Matrixiem637/Practice-Enterprise-1/Verslag/Fotos/shelly-plus-1-gen3-1-300x300.jpeg

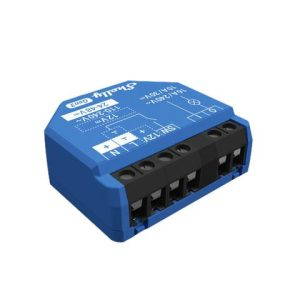
Verslag/Fotos/shelly-plus-1-gen3-1-300x300.jpeg
