Matrixiem637/Practice-Enterprise-1/Verslag/Fotos/WhatsApp Image 2026-05-21 at 21.13.31.jpeg

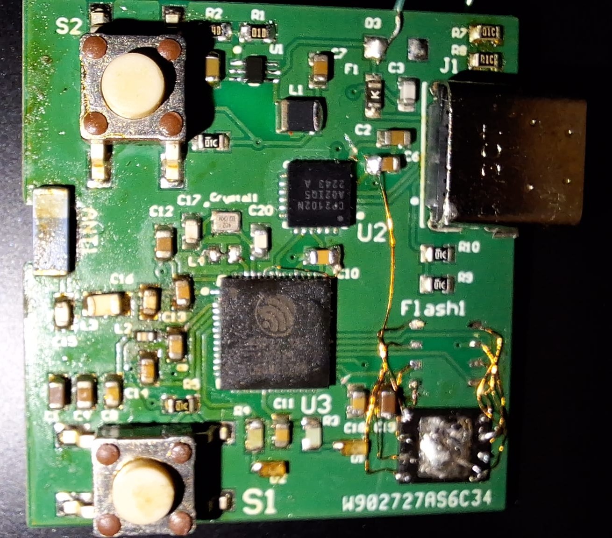
Verslag/Fotos/WhatsApp Image 2026-05-21 at 21.13.31.jpeg
