Matrixiem637/Practice-Enterprise-1/Verslag/PE1 project template 2025.docx

2025 - 2026

PE1 – Shelly Hub

By Dergent Toon and Mateusz Kidrycki

# 1. Preface

During the course Practice Enterprise 1, you will work on a project of your own choosing within a professional and enterprise-oriented context.

The aim of this course is to bridge the gap between theory and practice by allowing you to explore, develop, and realize a project that reflects your interests and ambitions.

Through this project we want to improve the following competences

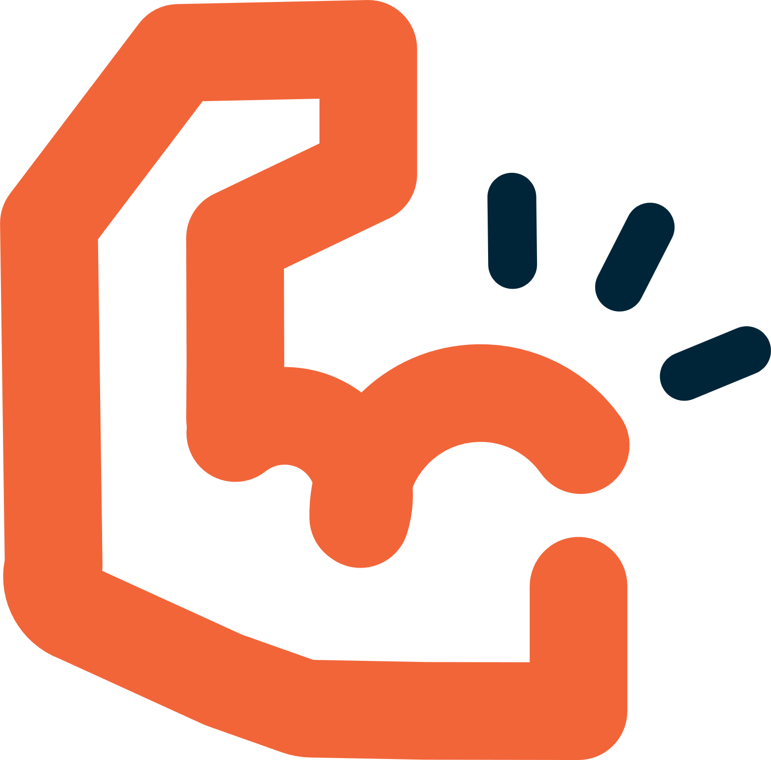
[picture p3: figure]

- Taking initiative and responsibility in defining and executing a project.
- Applying theoretical knowledge in a practical and structured manner.
- Developing professional communication and collaboration skills.
- Planning, organizing, and monitoring your own work.
- Reflecting critically on your process, decisions, and results.

Throughout the semester, you will independently (and where applicable, in team) work on your project. You are expected to define clear objectives, make well-founded choices, and document your progress in a structured and professional way.

This template serves as a guideline for documenting your project, process, and outcomes. It should provide a clear overview of your approach, the steps you have taken, and the results you have achieved.

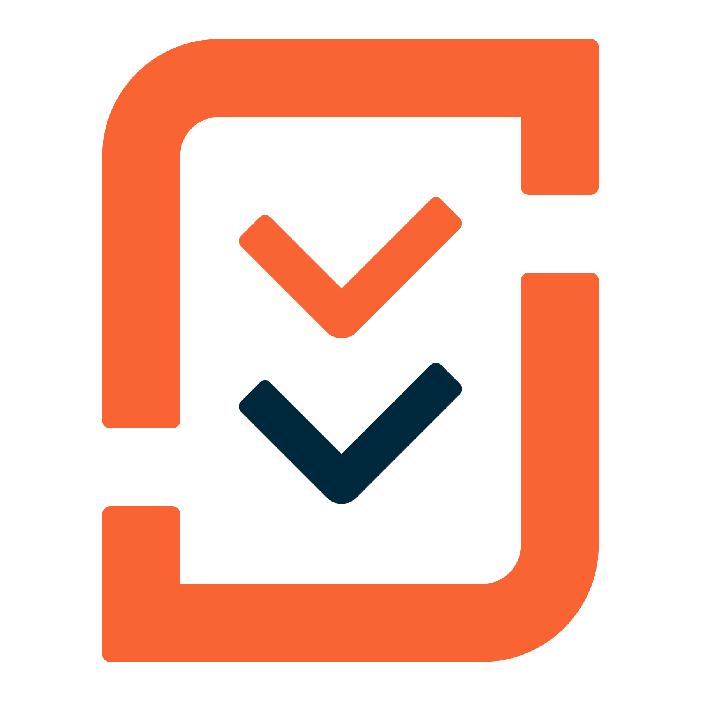
[picture p4: figure]

The following items need to be included:

- Project description and objectives
- Planning and approach
- Implementation and progress
- Communication and collaboration (if applicable)
- Reflection on decisions, challenges, and results
- Supporting material (e.g. screenshots, documents, reports, schematics, …)

Complete the different sections of this document throughout the semester. Feedback will be provided where necessary to support your learning process.

Please note this document should only be completed once per group!

Upload this document at the latest a day before your presentations on the assignment provided on canvas.

# 2. Group members

In the evaluation, different marks can be awarded to the members of the same project group as realization, contribution and knowledge are student dependent.

| Student 1 | Student 2
First name | Toon | Mateusz
Surname | Dergent | Kidrycki
R-number | R1093663 | R1094110

# 3. Project Definition

## 3.1. Project Description

### 3.1.1. Context and Motivation

Er is steeds meer vraag naar smart home apparaten, waarbij Shelly apparaten populair zijn vanwege hun open karakter en wifi connectiviteit. De motivatie voor dit project te creëren van een centrale hub om verschillende Shelly apparaten te beheren zonder afhankelijk te zijn van de standaard cloud app wat de privacy en snelheid ten goede komt.

### 3.1.2. Problem Statement

Het beheren van meerdere smart home apparaten via verschillende interfaces of een externe Cloud omgeving kan leiden tot vertraging, privacy zorgen en een gebrek aan overzicht. Er is behoefte aan een lokale gebruiksvriendelijke “hub” die alle Shelly apparaten binnen een netwerk visualiseert en aanstuurt.

## 3.2. Objectives

### 3.2.1. Main Objectives (Must-Haves)

- Automatische connectie of handmatige toevoeging van Shelly apparaten in het netwerk.
- Centraal dashboard voor bediening.
- Lokale communicatie.
- Automatisering op basis van tijd of sensoren.

### 3.2.2. Expansions (Nice-To-Haves)

- Real time statuslezing (Aan/Uit, stroomverbruik).
- Data logging (bv. Grafieken van stroomverbruik.
- Mobiele responsiviteit van de interface.

# 4. Preparation

## 4.1. What do you need for your project?

Voor de realisatie van ons project hebben we een eigen ontworpen PCB nodig die de centrale hub vormt van alle Shelly apparaten. Op deze printplaat plaatsen we een microcontroller met Wi-Fi zoals de ESP32 zodat de hub verbinding kan maken met het lokale netwerk (of hotspot). Dit is essentieel om de andere Shelly toestellen te kunnen opsporen en aan te sturen. Daarnaast hebben we componenten nodig voor de voeding en een aantal LEDs om te kunnen zien of de hub goed opstart en verbonden is.

Voor het ontwerpen van de elektronische schema’s en de lay-out van de printplaat gebruiken we Altium Designer. Het schrijven van de software voor de microcontroller doen we in Visual Studio Code. In deze code zorgen we ervoor dat de hub kan communiceren met de API van de Shelly apparaten.

## 4.2. Existing Solutions

Er bestaan natuurlijk al oplossingen zoals de officiële Shelly app en grote platformen zoals Home Assistant of Google Home. De app van Shelly werkt echter vaak via de Cloud en systemen zoals Home Assistant zijn vaak te complex.

Ons project is uniek omdat we niet alleen software maken maar ook de hardware zelf ontwerpen. We bouwen een fysiek hub op een eigen PCB die alles lokaal regelt zonder dat er internet voor nodig is. Hierdoor is onze oplossing een stuk sneller privacy vriendelijker en speciaal gemaakt voor wie een simpel en direct overzicht wil van zijn Shelly apparaten.

# 5. Planning

09/02-18/02 | Voorbereiden project + Voorstellen project
18/02-03/04 | Componenten Bestellen PCB ontwerpen + Bestellen
21/04 | PCB bestukken
21/04-22/05 | PCB bijwerken indien nodig + Code schrijven
11/05-24/05 | Verslag en PowerPoint opmaken
26/05 | Verdediging PE1

# 6. Realisation

## 6.1. What did you do?

### 6.1.1. Explanation of your work.

Nadat we het projectvoorstel hadden opgesteld en laten goedkeuren hebben we de ESP32S3 gekozen als centrale microcontroller vanwege de rekenkracht en de ingebouwde Wi-Fi ondersteuning. Na het vastleggen van de specificaties hebben we het elektrisch schema opgesteld en de juiste componenten geselecteerd met behulp van de datasheets. Vervolgens hebben we in Altium Designer de PCB lay-out ontworpen. Na feedback hebben we het design geoptimaliseerd en de PCB besteld.

Tijdens de levertijd van de PCB hebben we de software alvast grotendeels ontwikkeld op een ESP development bordje zodat we de communicatie met de Shelly API konden testen. Zodra de printplaten aangekomen waren hebben we deze zelf bestukt en gesoldeerd. Het laatste deel bestond uit het integreren van de software op onze eigen hardware en het valideren van de lokale hub functionaliteit.

### 6.1.2. Hardware

- ESP32S3: Dit is de kern van onze hub. We hebben voor de S3 variant gekozen vanwege de krachtige processor en de Wi-Fi mogelijkheden. Dit is essentieel om zowel de web interface te hosten als tegelijkertijd stabiel te communiceren met de Shelly apparaten in het netwerk.
- Flash Geheugen: Omdat de gekozen ESP32 geen ingebouwd geheugen heeft hebben we een externe flash chip bij op de PCB gezet. Hierop wordt de software die op de ESP moet runnen opgeslagen.
- USB naar UART-bridge: Om de microcontroller te kunnen programmeren en debuggen via de computer is er een bridge toegevoegd. Deze zorgt voor de vertaling van de USB-signalen naar de seriële data die de ESP32 kan verstaan en verwerken.
- Spanningsregeling: De hub krijgt zijn voeding via de USB-poort op 5V. omdat de ESP32 en de flash beide op 3.3V werken hebben we een regulator nodig om deze spanning stabiel en veilig om te vormen van 5V naar 3.3V.
- USB-C Connector: We hebben gekozen voor een USB-C aansluiting voor de voeding en data. Dit is niet alleen een moderne standaard maar het biedt ook een stevige mechanische verbinding op de printplaat.
- Cystal Oscillator: Voor de interne klok van de ESP32 hebben we een extern crystal toegevoegd. Dit component is nodig om de timing van de processor juist te laten lopen en zorgt ervoor dat de draadloze communicatie op de juiste frequentie verloopt.
- Antenne: Om een stabiel bereik te garanderen is er een antenne voorzien. Deze zorgt ervoor dat de hub ook op grotere afstanden probleemloos verbinding kan maken met het wifi netwerk en de Shelly devices.
- Status LED’s en Drukknop: Om zonder computer te kunnen zien wat de status van de hub is hebben we enkele LED’s toegevoegd. Zo kunnen we direct zien of de hub verbonden is met de wifi of apparaten. Ook is er een fysieke drukknop aanwezig om handmatige acties of reset te kunnen uitvoeren.

### 6.1.3. Software

#### 6.1.3.1. Ontwikkelomgeving: ESP-IDF

Voor de ontwikkeling van de firmware wordt gebruikgemaakt van het ESP-IDF framework(Espressif IoT Development Framework). Dit is het officiële framework van Espressif en heeft alle nodige drivers en libraries. FreeRTOS is hierin geïntegreerd als real-time besturingssysteem.

#### 6.1.3.2. Wifi-verbinding

De ESP32 verbindt zich met een bestaand wifi-netwerk als station. Om de web interface altijd bereikbaar te houden wordt een vast IP-adres ingesteld in plaats van een dynamisch adres via DHCP.

Wanneer er een gebeurtenis plaatsvindt, zoals het verkrijgen van een IP-adres of het verbreken van de verbinding, wordt automatisch een bijbehorende functie opgeroepen via de event loop van ESP-IDF. Bij verbindingsverlies probeert de ESP32 zelf opnieuw te verbinden. De systeemklok blijft ondertussen gewoon doorlopen.

#### 6.1.3.3. FreeRTOS en multitasking

FreeRTOS (Free Real-Time Operating System) maakt het mogelijk om meerdere taken tegelijk te laten uitvoeren. In ons project zijn er vier taken:
-WiFi status
-Shelly-Sequentie
-Tijdschema’s
-Drukknop

Taken die een netwerkverbinding nodig hebben, wachten tot wifi beschikbaar is via een Eventgroup.

#### 6.1.3.4. Tijdssynchronisatie via SNTP

Om tijdschema’s correct te kunnen uitvoeren moet de ESP32 de juiste tijd kennen. Dit gebeurt via SNTP (Simple Network Time Protocol), waarbij de tijd opgehaald wordt van externe tijdservers. Na synchronisatie wordt de Belgische tijdzone ingesteld, inclusief zomer- en wintertijd. De scheduler start pas wanneer de synchronisatie gelukt is.

#### 6.1.3.5. Webserver

De ESP32 draait een eigen HTTP-server op poort 80. De webpagina is rechtstreeks ingebouwd in de firmware, zodat er geen extern bestandssysteem nodig is.

De server biedt verschillende endpoints aan:
- /on en /off: schakelt de Shelly aan of uit.
- /start en /stop: beheert de aan/uit-sequentie.
- /status: geeft de huidige tijd, datum en tijdschema’s terug als JSON.
- /sched/add, /sched/del, /sched/toggle: beheer van tijdschema’s.

#### 6.1.3.6. Shelly schakelaar aansturen

De Shelly is een slim schakelaar op hetzelfde lokale netwerk. Om hem aan te sturen wordt een HTTP GET-verzoek naar zijn IP-adres met de gewenste toestand opgestuurd.
Bijvoorbeeld: http://10.165.226.20/rpc/Switch.Set?id=0&on=true

#### 6.1.3.7. Tijdschema’s

Er kunnen 8 tijdschema’s ingesteld worden. Elk schema bevat een tijdstip en een actie, aan of uit. Elke 10 seconden wordt de huidige tijd vergeleken met de schema’s. Wanneer een schema overeenkomt wordt de Shelly aangestuurd.

#### 6.1.3.8. Webinterface

De webinterface is een simpel HTML-pagina die door de ESP32 zelf gehost wordt. Ze toont de huidige tijd, laat toe de Shelly rechtstreeks te bedienen en biedt een overzicht van de ingestelde tijdschema’s. De pagina wordt elke seconde automatisch bijgewerkt via een achtergrondoproep naar de /status endpoint.

#### 6.1.3.9. LED-indicator

Een LED op GPIO2 knippert continu. Zolang de ESP32 verbonden is met het netwerk, knippert hij traag. Vanaf het moment hij verbinding heeft verloren begint hij snel te knipperen.

### 6.1.4. Tools and methods used.

Voor het hardware-ontwerp hebben we Altium Designer gebruikt voor zowel het schema als de PCB lay-out terwijl de softwareontwikkeling is uitgevoerd in Visual Studio Code. Bij de assemblage van de printplaat hebben we gebruik gemaakt van een stencil om de soldeerpasta nauwkeurig aan te brengen waarna de meeste componenten via een reflow oven zijn gesoldeerd. De resterende onderdelen hebben we naderhand handmatig gemonteerd. Voor de uiteindelijke controle en het doormeten van de verbindingen is een multimeter of oscilloscoop gebruikt.

## 6.2. Problems & Solutions

Tijdens de eerste tests liepen we tegen verschillende hardware problemen aan. Het eerste probleem was een fysieke verbindingsfout. De USB-C poort maakte geen volledig contact met de PCB waardoor er geen data overdracht mogelijk was. Dit hebben we opgelost door de poort opnieuw te solderen en de verbinding te controleren.

Nadat de USB-verbinding was hersteld bleek het nog steeds niet mogelijk om code naar de ESP32 te schrijven. Na een controle van alle soldeerverbindingen en spanningsniveaus ontdekten we dat het externe flash geheugen niet de vereiste 3.3V ontving. Ondanks het correct configureren van de verantwoordelijke pin op de ESP32 bleef de ESP32 de foute spanning geven (zie figuur 1). Ook het vervangen van componenten om kapotte componenten uit te sluiten was geen oplossing.

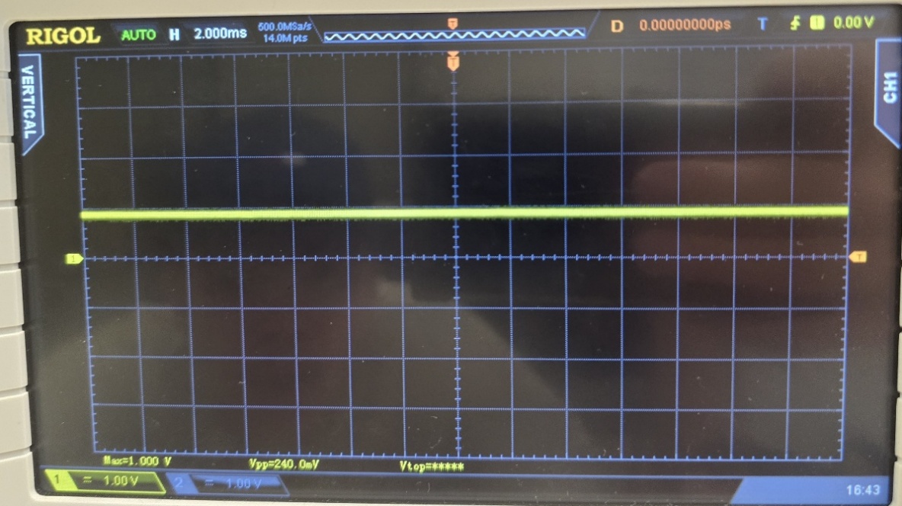
[picture p5: figure]

Daarnaast vonden we een fout in het ontwerp van de UART bridge die op 5V was aangesloten in plaats van de vereiste 3.3V. Dit hebben we handmatig gecorrigeerd door de betreffende trace op de PCB door te krassen en met een jumperdraad een directe verbinding naar de 3.3V te maken. Na het aanpassen van de spanning op de UART-bridge bleken we nog steeds geen connectie te kunnen maken met de ESP32.

Figuur 1: Meting van het afwijkende spanningsniveau op de voeding van het Flash geheugen

# 7. Testing & Validation

## 7.1. Troubleshooting

Nadat de printplaten binnenkwamen merkten we eigenlijk direct al een probleem: de pads voor het flash geheugen op de PCB waren te klein voor de chip die we besteld hadden. Omdat we de rest van de componenten wel alvast wilden solderen hebben we de plaat eerst door de oven gestuurd zonder de flash erop. Nadat de print uit de oven kwam hebben we de flash er alsnog op gezet door middel van dunne draadjes om de pads op de PCB te verbinden met de pinnen van de flash. Tijdens het flashen naar de chip liepen we echter tegen nieuwe problemen aan. Het flash geheugen kreeg niet de nodige 3.3V dus hebben we dit na veel testen uiteindelijk opgelost door de input direct aan te sluiten op de 3.3V in plaats van de voltage output van de ESP te gebruiken. Daarna kwamen we erachter dat we de UART-bridge op 5V hadden aangesloten en niet op de nodige 3.3V. Dit hebben we opgelost door de trace door te krassen en de pin te verbinden met de 3.3V.

## 7.2. Final result

Het uiteindelijk resultaat is een project dat qua software volledig functioneel is maar qua hardware helaas nog niet. Ondanks de verschillende aanpassingen aan de flash chip en de spanningslijnen is het ons niet gelukt om de ESP32 op onze eigen PCB succesvol de flashen. Omdat we de exacte oorzaak van dit probleem binnen de beschikbare tijd niet konden vinden werkt onze zelfontworpen printplaat momenteel niet.

Om toch aan te tonen dat onze centrale hub en de bijhorende code werkt zullen we de demonstratie uitvoeren met behulp van een development kit bordje. Hierop is te zien dat we vanop afstand onze Shelly apparaten kunnen aansturen.

## 7.3. What went well?

Het proces begon goed met de ontwerpfase in Altium Designer waarbij het opstellen van de elektrische schema’s en het uittekenen van de PCB lay-out erg vlot verliepen. Ook de uiteindelijke realisatie in de oven was vlot verlopen. Hoewel de flash chip later handmatig moest worden toegevoegd vanwege de foute footprint zaten alle overige SMD-componenten direct op de juiste plek en oogde de printplaat na assemblage erg kwalitatief (zie figuur 2). Op het gebied van software was het project eveneens een succes. De logica om Shelly apparaten automatisch te verbinden en aan te sturen via de lokale API werkt volledig stabiel op de development kit. Ten slotte zijn we tevreden over onze probleemoplossende aanpak aangezien we erin geslaagd zijn de diverse hardware matige tegenslagen te analyseren en op te lossen.

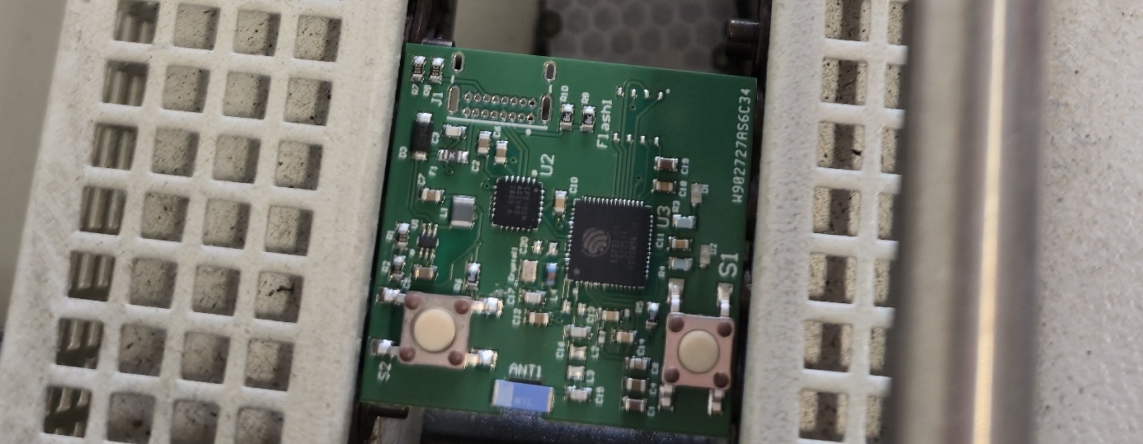
[picture p6: figure]

Figuur 2: De PCB nadat hij uit de oven kwam

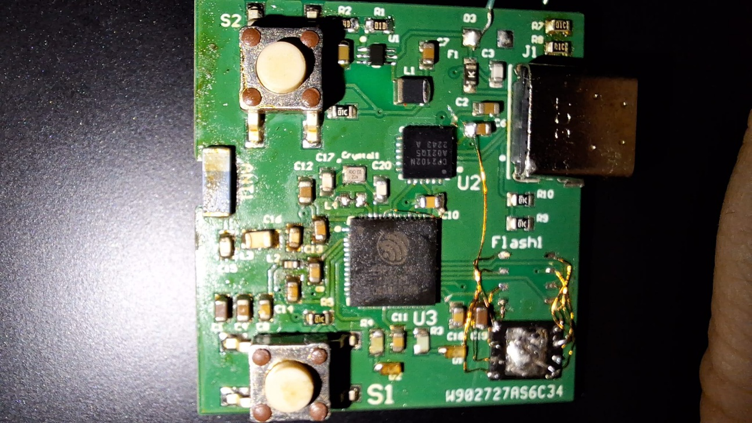
[picture p7: figure]

## 7.4. What went wrong?

Tijdens de realisatie kwamen we enkele ontwerpfouten tegen die de uiteindelijke werking van de hardware tegenhielden. De ergste fout was de onjuiste footprint van de flash chip wat ons dwong tot handmatig verbinden van de chip (zie figuur 3). Daarnaast bevatten de elektrische schema’s fouten in de spanningsniveaus waarbij de UART-bridge op 5V was aangesloten en het flash geheugen niet de vereiste 3.3V ontving van de ESP. Ondanks pogingen om dit te herstellen door traces door te krassen en jumpdraden te plaatsen bleef het probleem. Hierdoor was het onmogelijk om de ESP32 op onze eigen PCB te flashen waardoor we de uiteindelijk werking enkel op een development board hebben kunnen realiseren.

Figuur 3: De PCB met jumperdraden op

# 8. Reflection

## 8.1. What did you learn?

In dit project hebben we geleerd hoe we een project volledig vanaf nul moeten aanpakken van het brainstormen tot de uiteindelijke fysieke realisatie. We hebben ervaren hoe we een concept kunnen omvormen naar een ontwerp waarbij we de balans moesten zoeken tussen de hardware eisen en de softwareontwikkeling. Door het gebruik van Altium Designer hebben we kennis opgedaan over de volledige werking van pcb-ontwerp zoals het koppelen van de juiste footprints aan componenten en het uittekenen van een goede lay-out. Ten slotte hebben we onze praktische vaardigheden aanzienlijk verbeterd door het zelfstandig bestukken van de printplaat. Hierbij hebben we geleerd om uiterst nauwkeurig te werken tijdens het solderen van de kleine SMD-componenten.

## 8.2. What would you do differently?

Bij een volgend project zouden we kiezen voor een ESP32 variant met intern flash geheugen om de hardware matige complexiteit te verminderen. De externe flash zorgde in dit ontwerp namelijk voor grote uitdagingen zoals een onjuiste footprint en problemen met de 3.3V voeding. Door te kiezen voor een chip met intern geheugen vermijden we deze foutgevoelige verbindingen en wordt de stabiliteit van de schakeling aanzienlijk vergroot. Daarnaast zouden we de through hole USB-C poort vervangen door een SMD-poort voor een betere verbinding op de PCB. Een SMD-variant kan nauwkeuriger worden gesoldeerd in de oven wat het assemblageproces vereenvoudigt en de kans op fouten verkleint. Deze aanpassingen zouden ervoor gezorgd hebben dat de hardware sneller functioneel was wat ons meer tijd had gegeven voor de verdere softwareontwikkeling.

GitHub Repository: https://github.com/Matrixiem637/Practice-Enterprise-1

Follow us

www.thomasmore.be

fb.com/ThomasMoreBE

#WeAreMore

PE1 – Shelly Hub
