Matrixiem637/Practice-Enterprise-1/Verslag/Powerpoint PE.pptx

## PE1 – Shelly Hub

By Dergent Toon and Kidrycki Mateusz

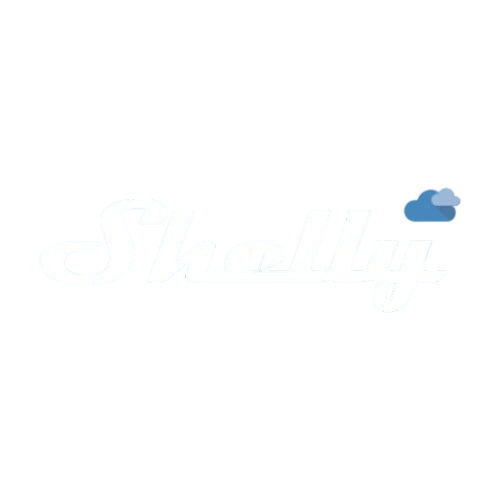
[picture p9: figure]
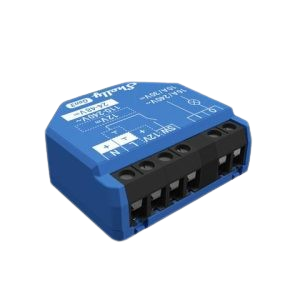
[picture p10: figure]

Notes: Introductie en zich voorstellen.
Mateusz

## Idee

- Shelly Hub
  - Lokaal
  - Meer privacy
  - Volledig aanpasbaar

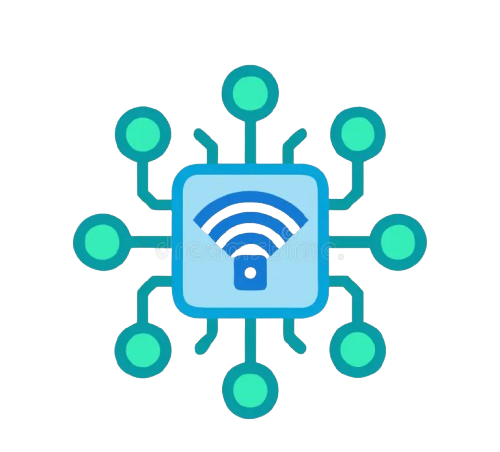
[picture p11: figure]

Notes: Uitleggen project en waarom.
Toon

## Componenten

ESP32S3
128 Mbit Flash
2,4 GHz Antenne
40 MHz Crystal
USB-C poort
UART Bridge
Drukknoppen
Buck-Converter

Notes: Opsomming van componenten en zeggen waarom. Waarom extern flash?
Mateusz

## Schema’s Hardware

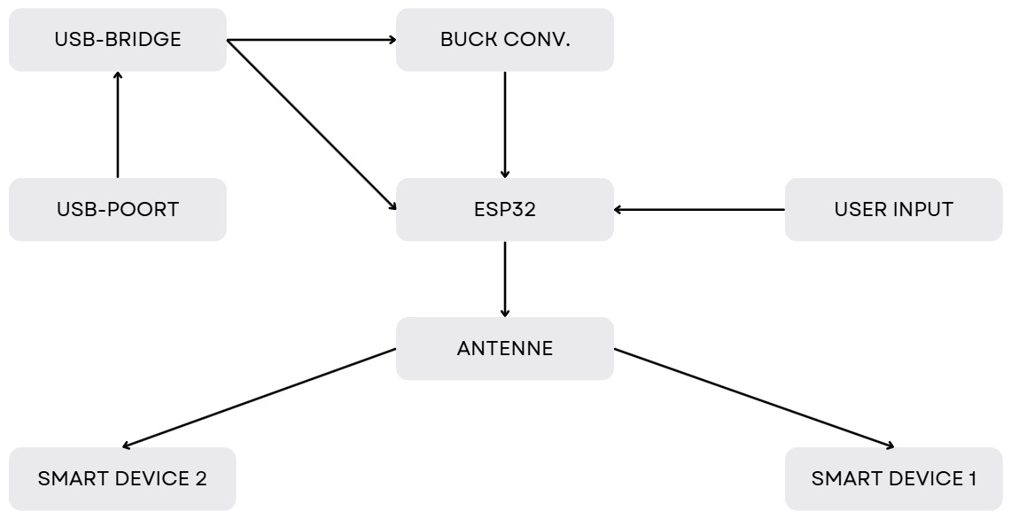
[picture p12: figure]
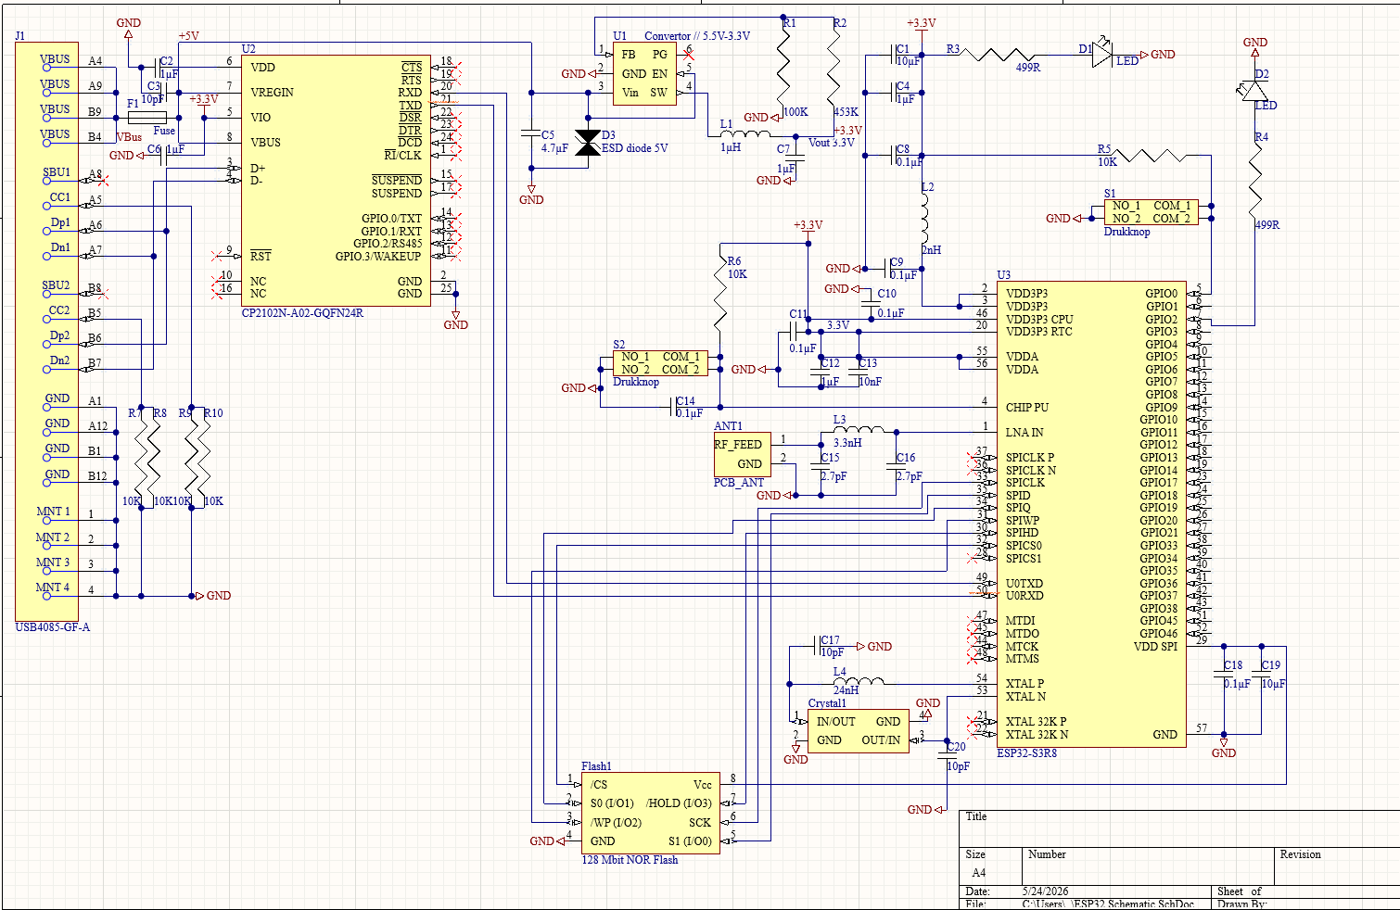
[picture p13: figure]

Notes: Samenstelling uitleggen. Welke functie de componenten hebben.
Toon

## PCB

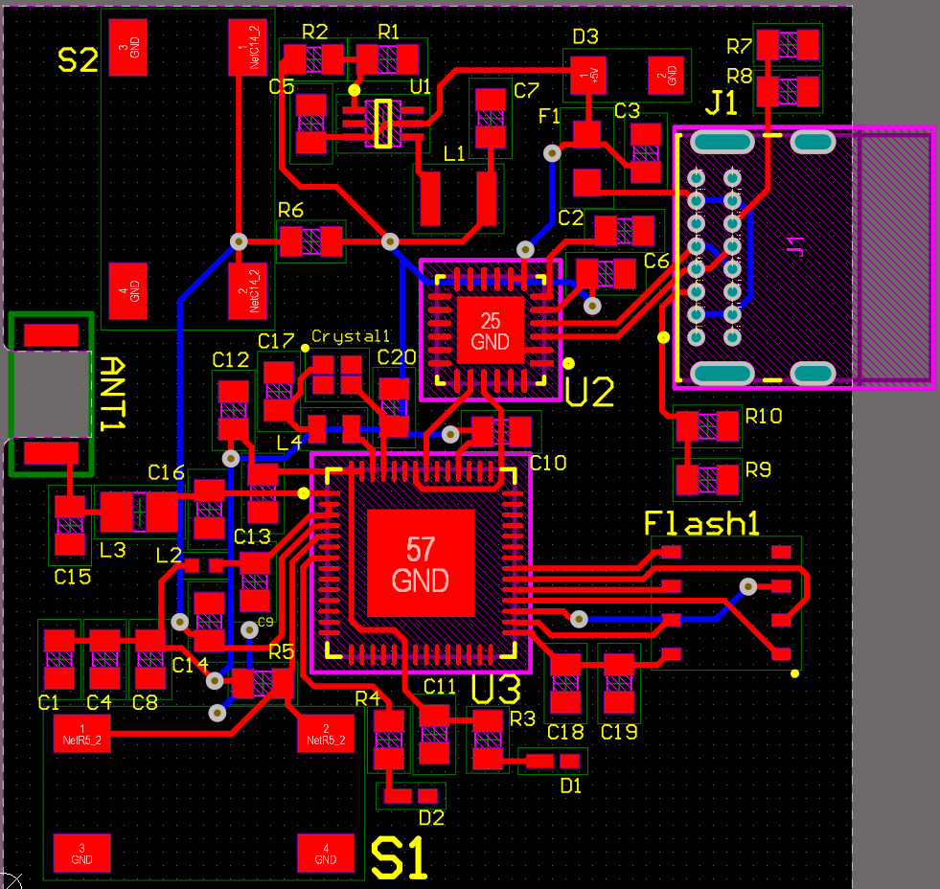
[picture p14: figure]

Notes: Waarom zo dicht op mekaar? Storingen te beperken…
Toon

## Hardware Fouten

- Flash paden
- Spanning Flash
- Spanning UART bridge
- Connecties solderen

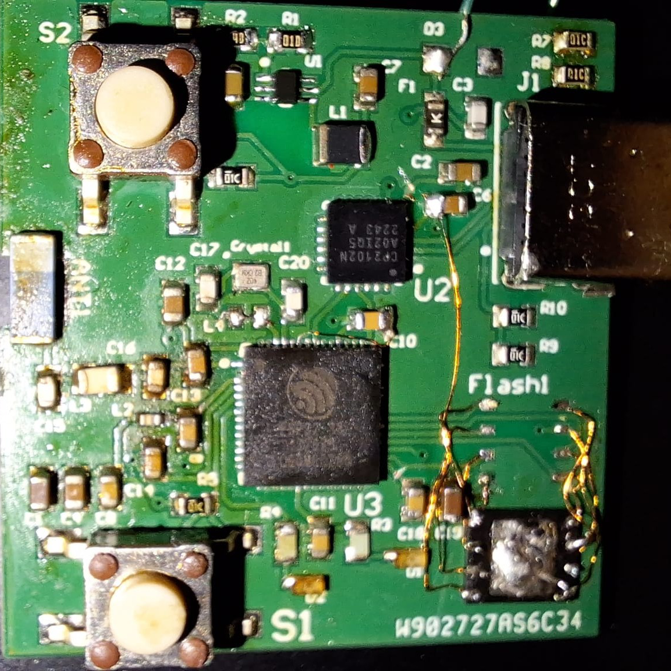
[picture p15: figure]

Notes: Elke fout bespreken, wa er werd gedaan om die op te lossen.
Toon

## Flash

- Paden
- Spanning

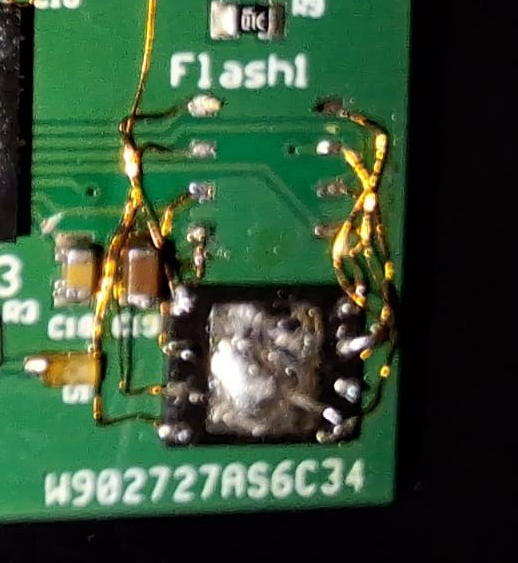
[picture p16: figure]

Notes: Waarom moest de flash zo gemonteerd worden.
Spanning: Voor een of ander reden kwam er niet genoeg spanning vanuit de VDD_SPI pin naar de flash, dus we trokken een draadje direct vanuit een 3v3 rail.
Toon

## Spanning UART bridge

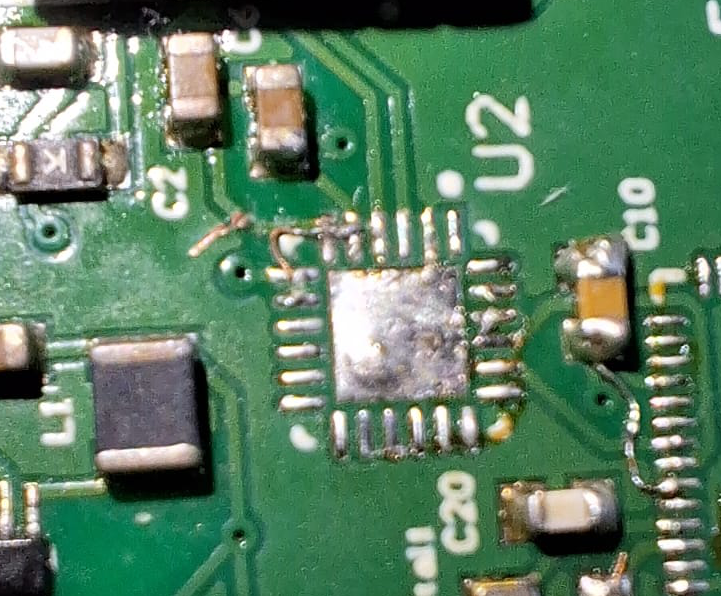
[picture p17: figure]
The image shows a circuit board with various components and labels, including capacitors (C12, C17Cvdl, C16), transistors (C2, T R9), and an antenna (ANTI). Door AI gegenereerde inhoud is mogelijk onjuist.

Een brug gemaakt om 3.3V op de correcte paden te zetten

Traces gesneden

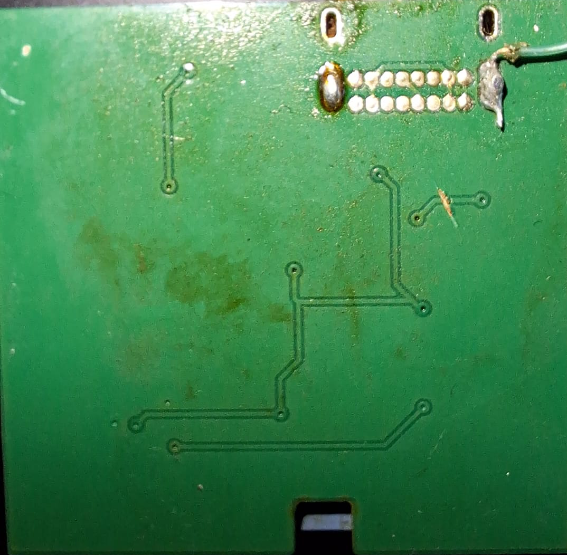
[picture p18: figure]
The image shows a circuit board with visible components and connections, and a small, greenish area near the bottom right corner. Door AI gegenereerde inhoud is mogelijk onjuist.

Notes: Traces gesneden omdat 1 pin naar gnd verbonden was, maar moest 3,3v krijgen en ander pin 5v kreeg, maar die moest ook 3.3V krijgen en dan dus met die brugeske ze allebei van 3.3V voorzien.
Toon

## BlokSchema Software

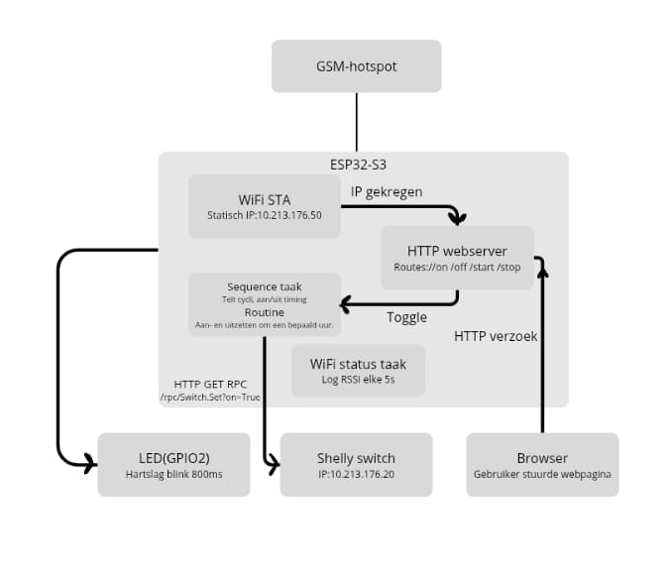
[picture p19: figure]
The diagram illustrates a system configuration for a GSM-Hotspot, ESP32-S3, featuring WiFi, an HTTP webserver, and various interconnected services including web requests, status monitoring, RPCs, LED control, and a web page display. Door AI gegenereerde inhoud is mogelijk onjuist.

Notes: Werkwijze uitleggen, wa waarvoor dient.
Mateusz

## Software Fouten

- Met onze PCB: No serial data received.
- Met de DevKit:
  - Invalid head of packet => Te hoge Baudrate.
  - Verkeerde subnet gekozen.

Notes: Zeggen wat no serial data received betekent, en wa we hadden gedaan om dit proberen op te lossen.
Wa invalid head of packet betekent. Wa is baudrate.
Wa bedoel ik met verkeerde subnet.
Mateusz

## Budget

- Gepland
  - €80-€100
- Werkelijkheid
  - Componenten: €110-120
  - PCB: €60

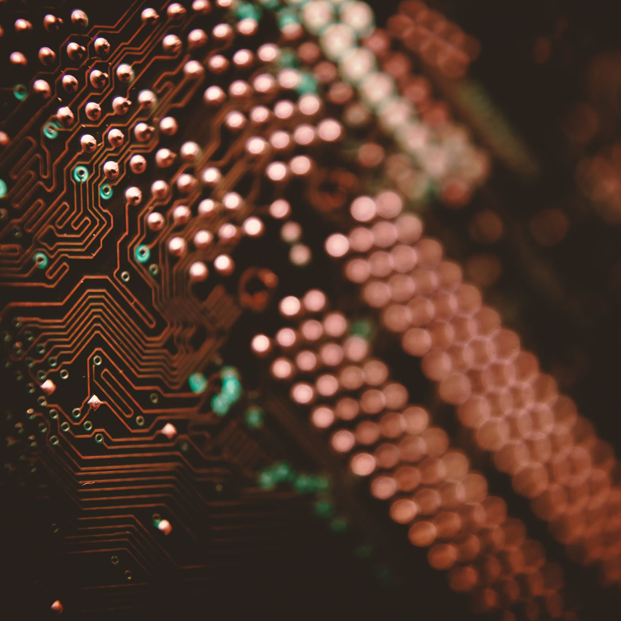
[picture p20: figure]
Close-up of illuminated circuit board

Notes: Gewoon zeggen wa der op den dia staat?
Mateusz

## Conclusie

Notes: Mateusz
