Matrixiem637/Practice-Enterprise-1/Verslag/Tekst PE1.docx

PE1 presentatie

Dia 1: Goede morgen, ik ben Mateusz Kidrycki “en ik ben Toon Dergent”. Vandaag gaan we jullie ons project voorstellen.

Dia 2:

Dia 3:

Dia 4:

Dia 5:

Dia 6:

Dia 7:

Dia 8:

Dia 9:

Dia 10:

Dia 11:

Dia 12:
