Matrixiem637/Practice-Enterprise-1/Schema's/Final schema.pdf

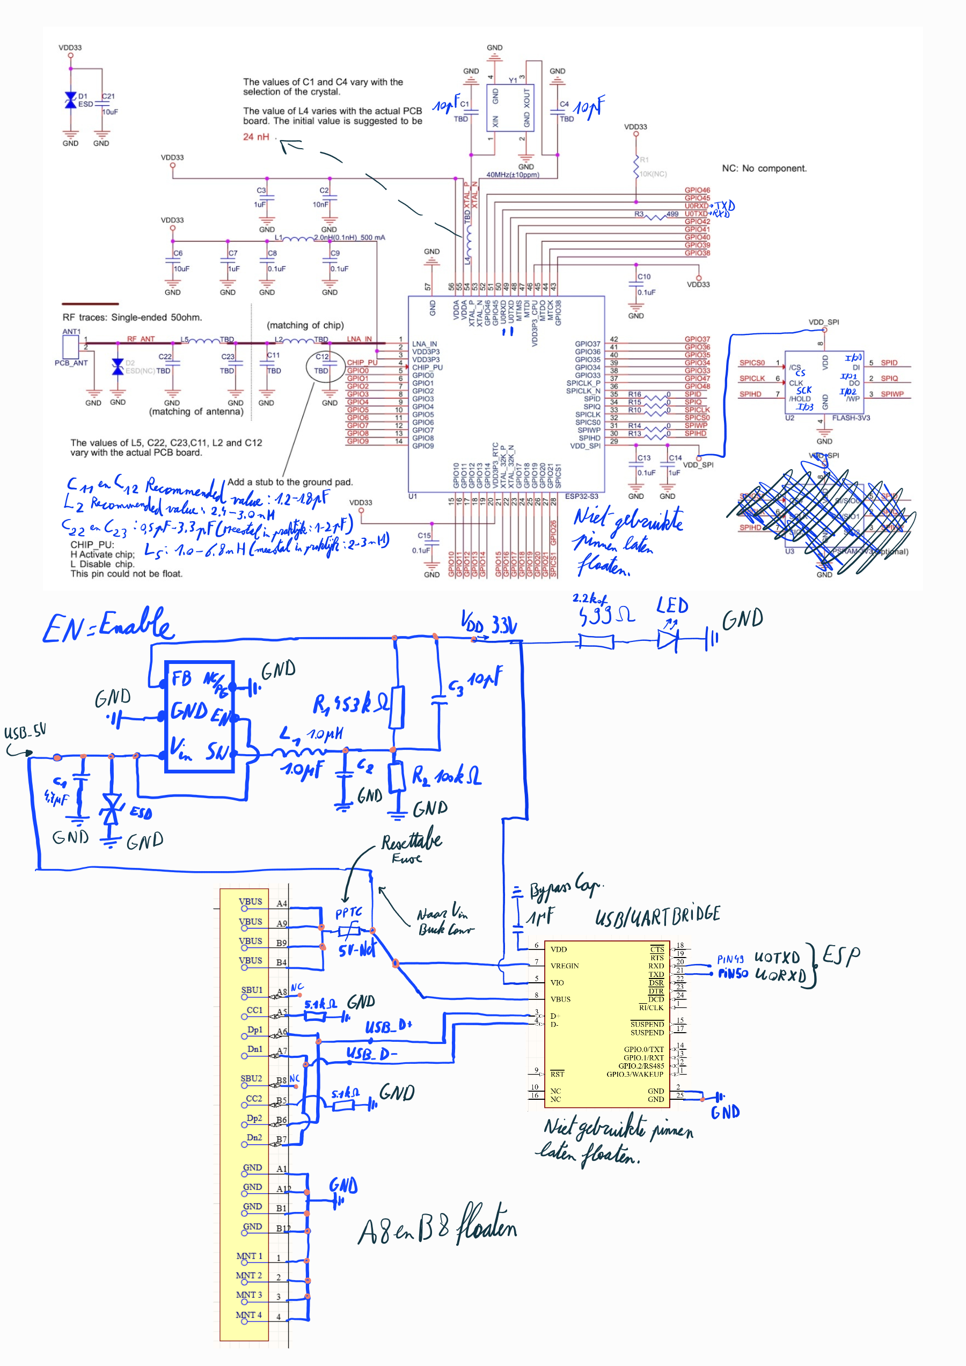
[picture p21: page 1]
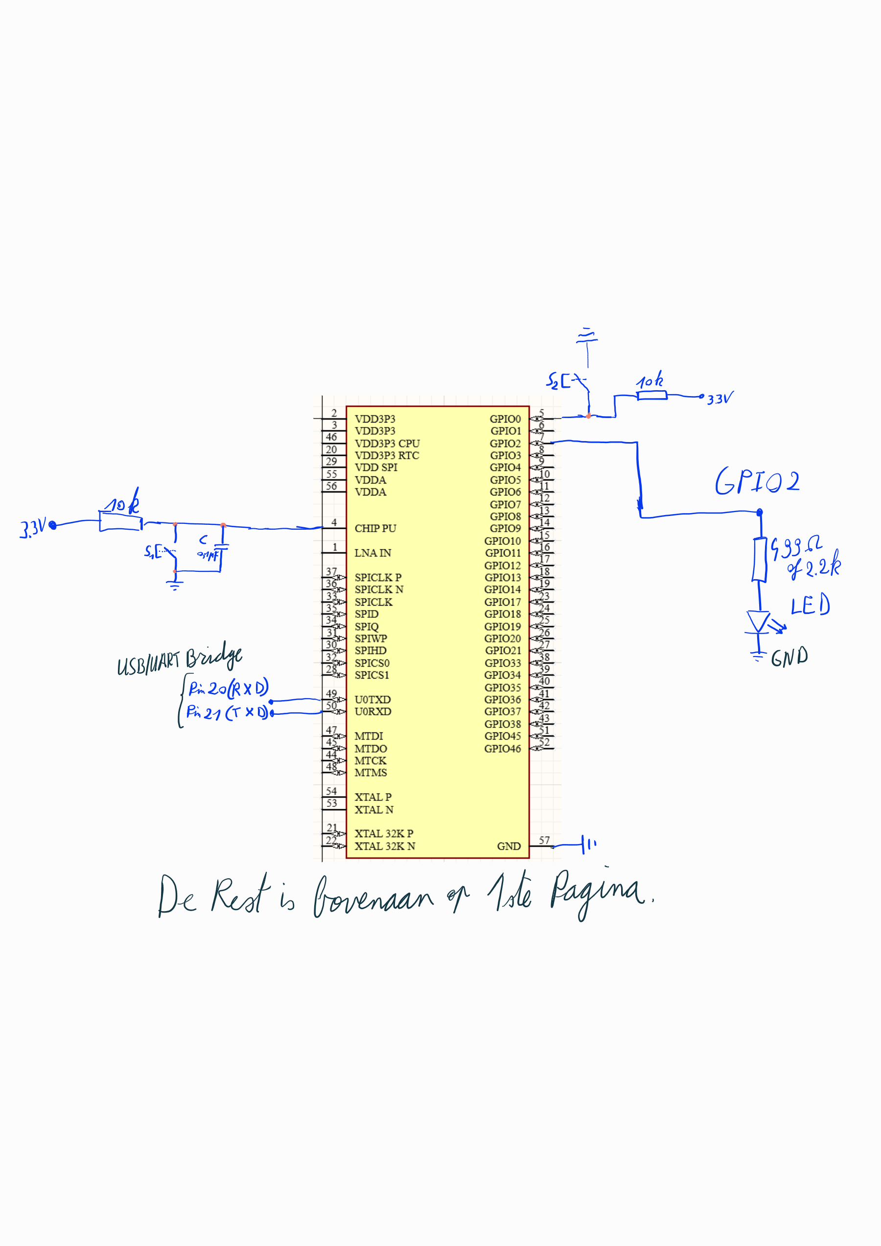
[picture p22: page 2]
