Matrixiem637/Practice-Enterprise-1/Schema's/Schema.pdf

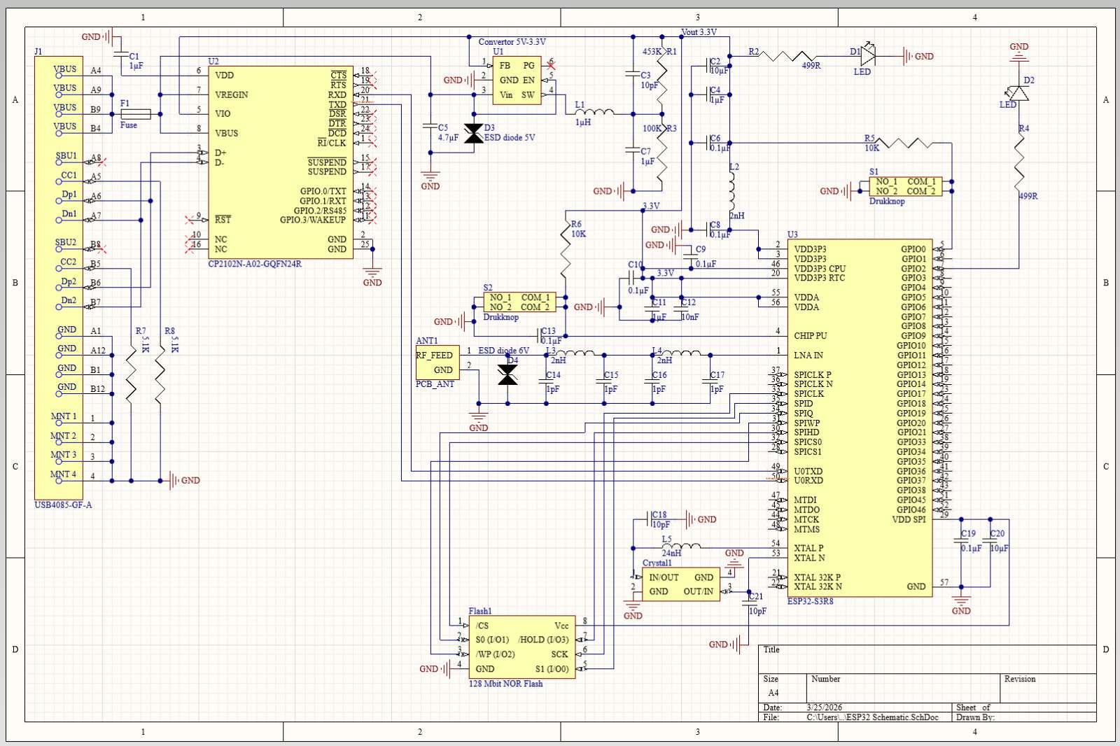
[picture p23: page 1]
