Matrixiem637/Practice-Enterprise-1/Verslag/Taakverdeling.xlsx

Taakverdeling – Project Shelly Hub
Legenda: |  | Allebei | Toon Dergent | Mateusz Kidrycki
# | Taak | Verantwoordelijke | Tijd (Ongeveer)
1 | Research | Allebei | 1 Week
2 | Componenten zoeken | Allebei | 1 Week
3 | Altium Designer | Toon Dergent | 35 uur
4 | Bestukken | Toon Dergent | 5-6 uur
5 | Software/Code | Mateusz Kidrycki | 22-26 uur
6 | Hardware Troubleshooting | Allebei | 3-4 Weken
7 | Verslag/PPT | Allebei | 25-27 uur
