Matrixiem637/Practice-Enterprise-1/flash sequence.png

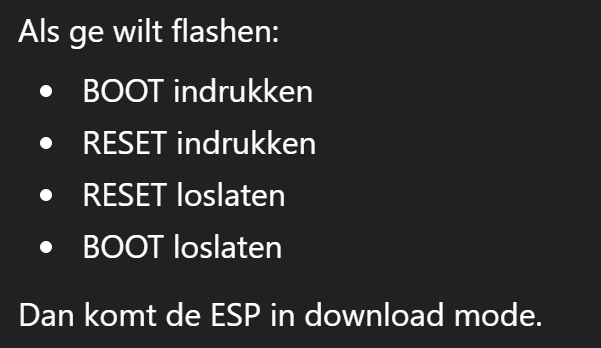
flash sequence.png
