Matrixiem637/Practice-Enterprise-1/Schema's/antenne berekend regeling.png

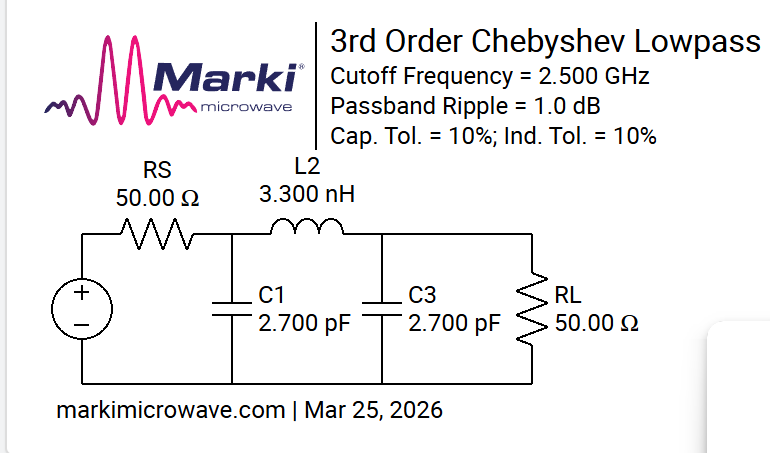
Schema's/antenne berekend regeling.png
