Matrixiem637/Practice-Enterprise-1/Schema's/ESD Diode 3.3 schema en pad layout richtlijn.png

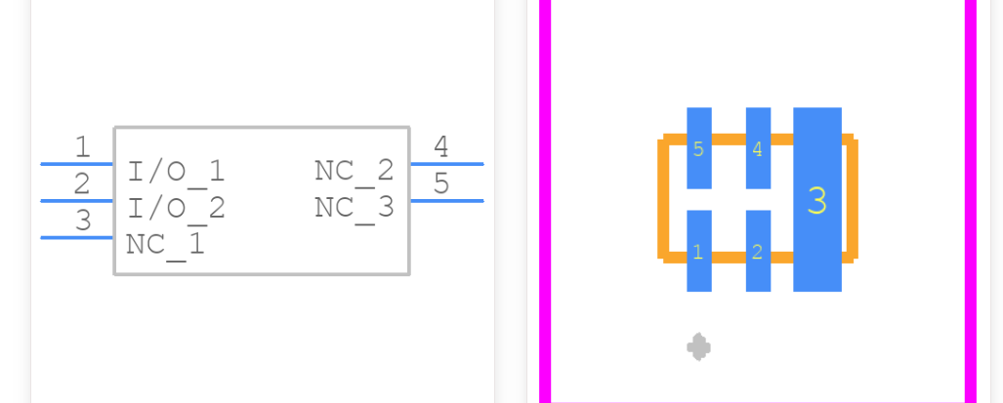
Schema's/ESD Diode 3.3 schema en pad layout richtlijn.png
