Matrixiem637/Practice-Enterprise-1/Schema's/Schema Final.png

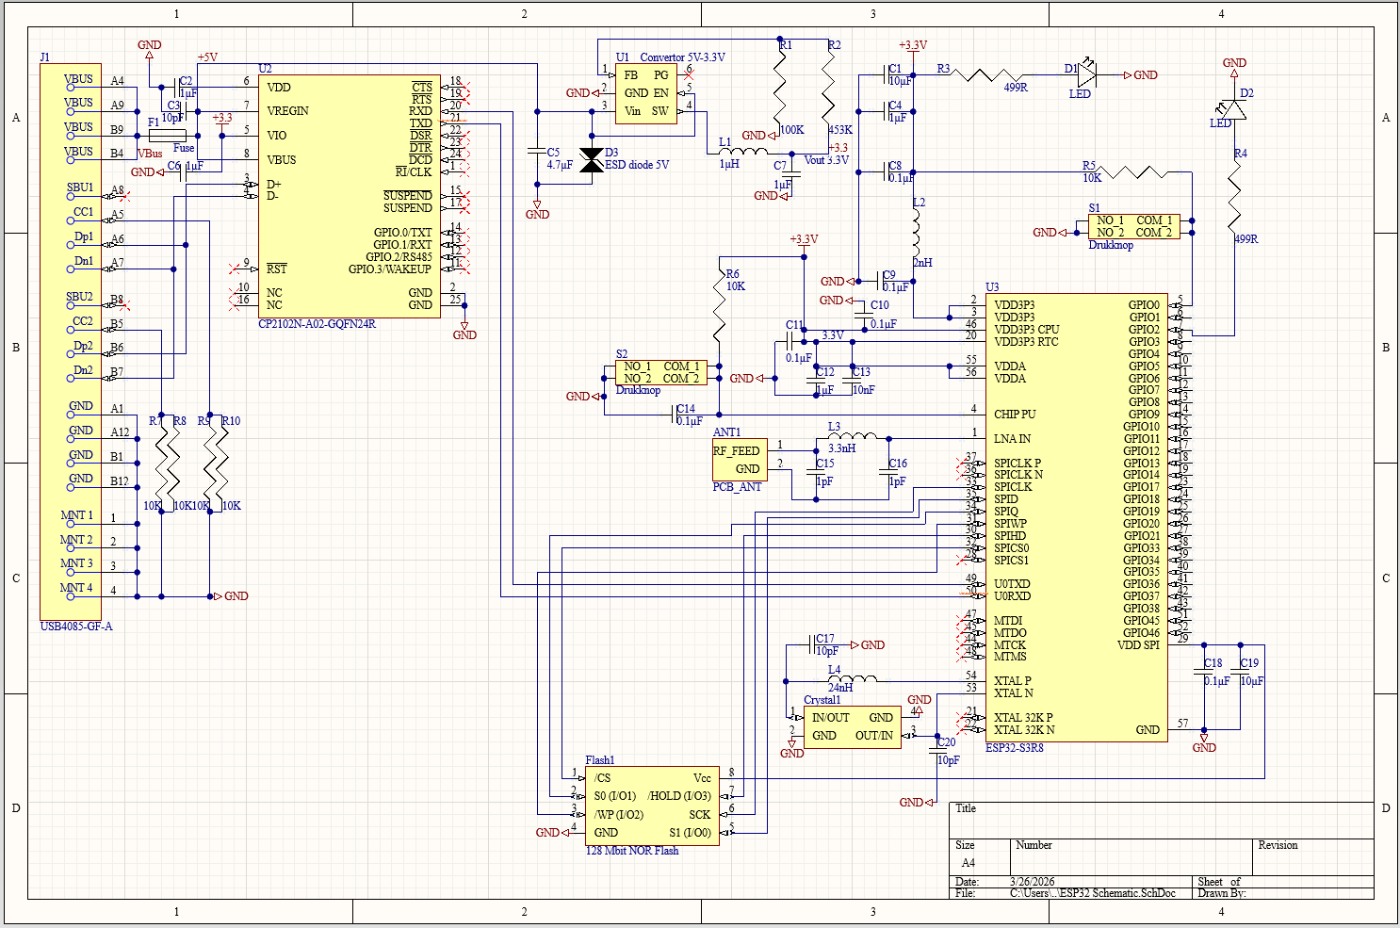
Schema's/Schema Final.png
