Matrixiem637/Practice-Enterprise-1/Schema's/Schema.png

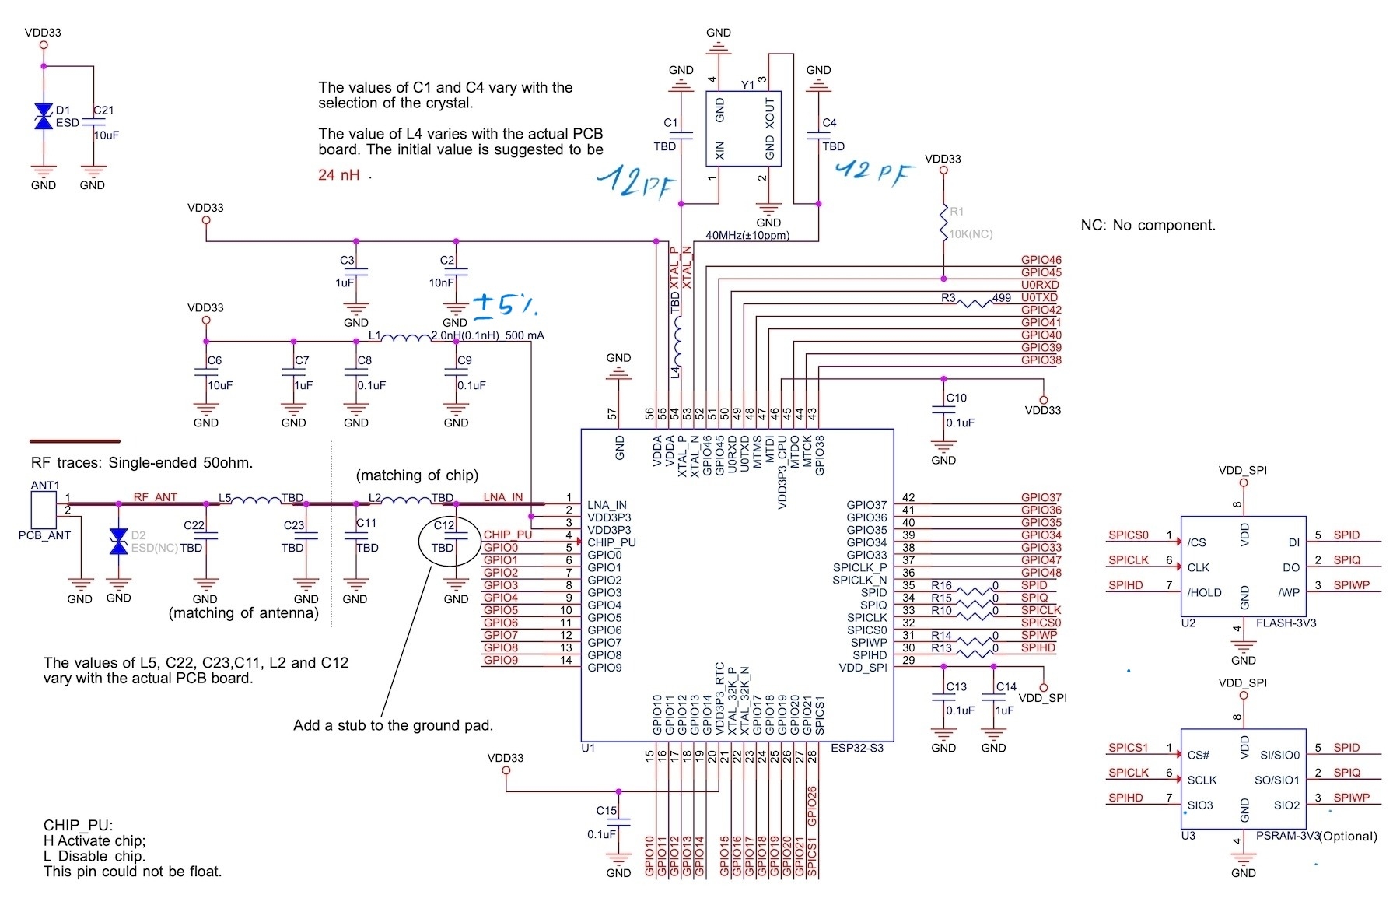
Schema's/Schema.png
