Matrixiem637/Practice-Enterprise-1/Verslag/Fotos/unnamed.png

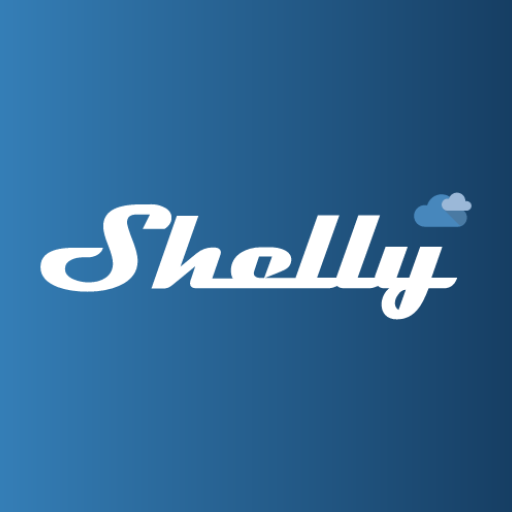
Verslag/Fotos/unnamed.png
