Matrixiem637/Practice-Enterprise-1/Verslag/Fotos/unnamedé-removebg-preview.png

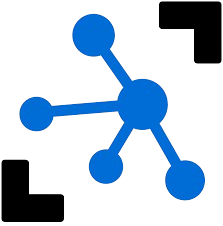
Verslag/Fotos/unnamedé-removebg-preview.png
