Matrixiem637/Practice-Enterprise-1/Verslag/ESP32 Schematic.pdf

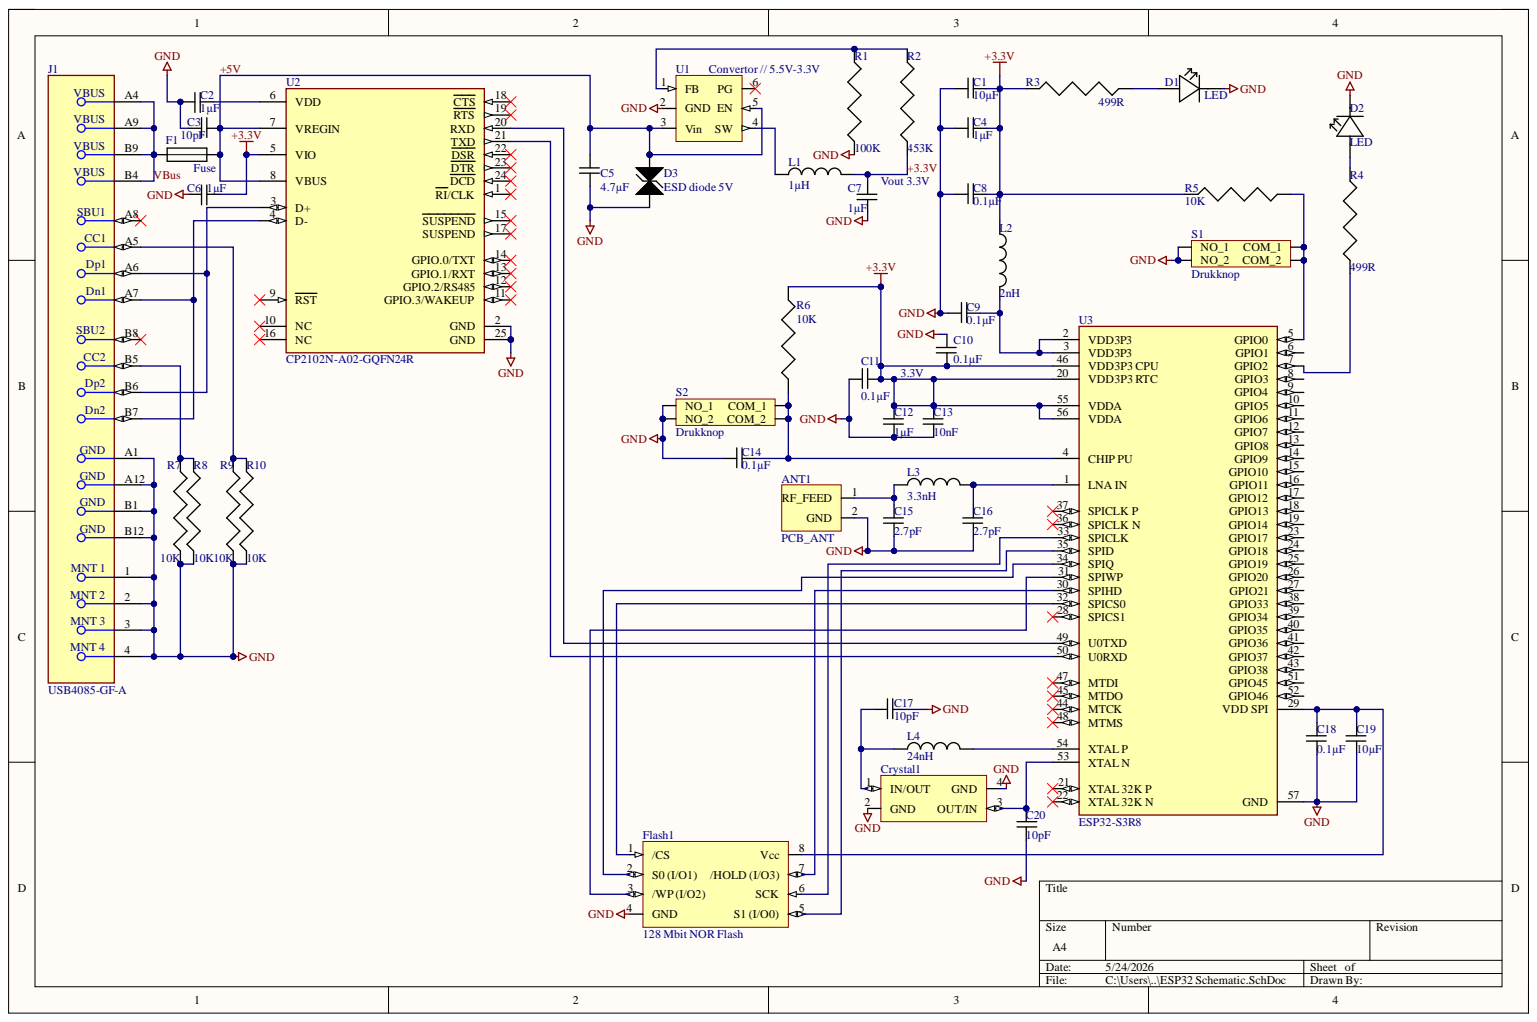
[picture p31: page 1]

+3.3 V | 5 8 | VRE G IN RX D T X D V I O DSR D T R VBU S D C D RI/CL K D + D -SUSPE N D SUSPE N D GPIO.0 / T X T GPIO.1 / RX T GPIO.2 /RS4 8 5 GPIO.3 / WA KE U P N C G N D N C G N D | 2 1 1 RST

1 0 | 2
1 6 | 2 5

4 6 | 7

3 5
3 4
3 1
3 0
3 2
2 8

Flas h 1 | 4 7
