Matrixiem637/Practice-Enterprise-1/(list of files, drawings)

Other design files:
Altium Project/1. Old Mistakes/Capacitors-Footprint-Library.PcbLib
Altium Project/1. Old Mistakes/Capacitors-Library.SchLib
Altium Project/1. Old Mistakes/PE_PCB/PcbLib1.PcbLib
Altium Project/1. Old Mistakes/PE_PCB/PE_PCB.PrjPcb
Altium Project/1. Old Mistakes/PE_PCB/RES_27R_0603.PcbLib
Altium Project/1. Old Mistakes/PE_PCB/RES_27R_0603.SchLib
Altium Project/1. Old Mistakes/PE_PCB/Schlib1.SchLib
Altium Project/1. Old Mistakes/Resistors-Footprint-Library.PcbLib
Altium Project/1. Old Mistakes/Resistors-Library.PcbLib
Altium Project/1. Old Mistakes/Resistors-Library.SchLib
Altium Project/PCB-Library.PcbLib
Altium Project/PE/ESP32 Schematic.SchDoc
Altium Project/PE/Old/PCB-v1.PcbDoc
Altium Project/PE/PCB-Library.PcbLib
Altium Project/PE/PCB-v1.PcbDoc
Altium Project/PE/PCB-v2.PcbDoc
Altium Project/PE/PCB-v3.PcbDoc
Altium Project/PE/PE.PrjPcb
Altium Project/PE/Schematic-Library.SchLib
Altium Project/Schematic-Library.SchLib
