Matrixiem637/Practice-Enterprise-1/(commit log)

2026-05-21 Eerste commit
    [Capacitors-Footprint-Library.PcbLib, Capacitors-Library.SchLib, ESP32 Schematic.SchDoc, PCB-Library.PcbLib, PCB-v1.PcbDoc, PCB-v2.PcbDoc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]
2026-05-24 Taakverdeling toegevoegd
    [Taakverdeling.xlsx]
2026-05-24 Laatste update
    [Taakverdeling.xlsx]
